UWCubeSat/coffee-can-radar/coffee-spring21/coffee-spring21.kicad_pcb

## KiCad design coffee-spring21/coffee-spring21.kicad_pcb (2021-04-18)

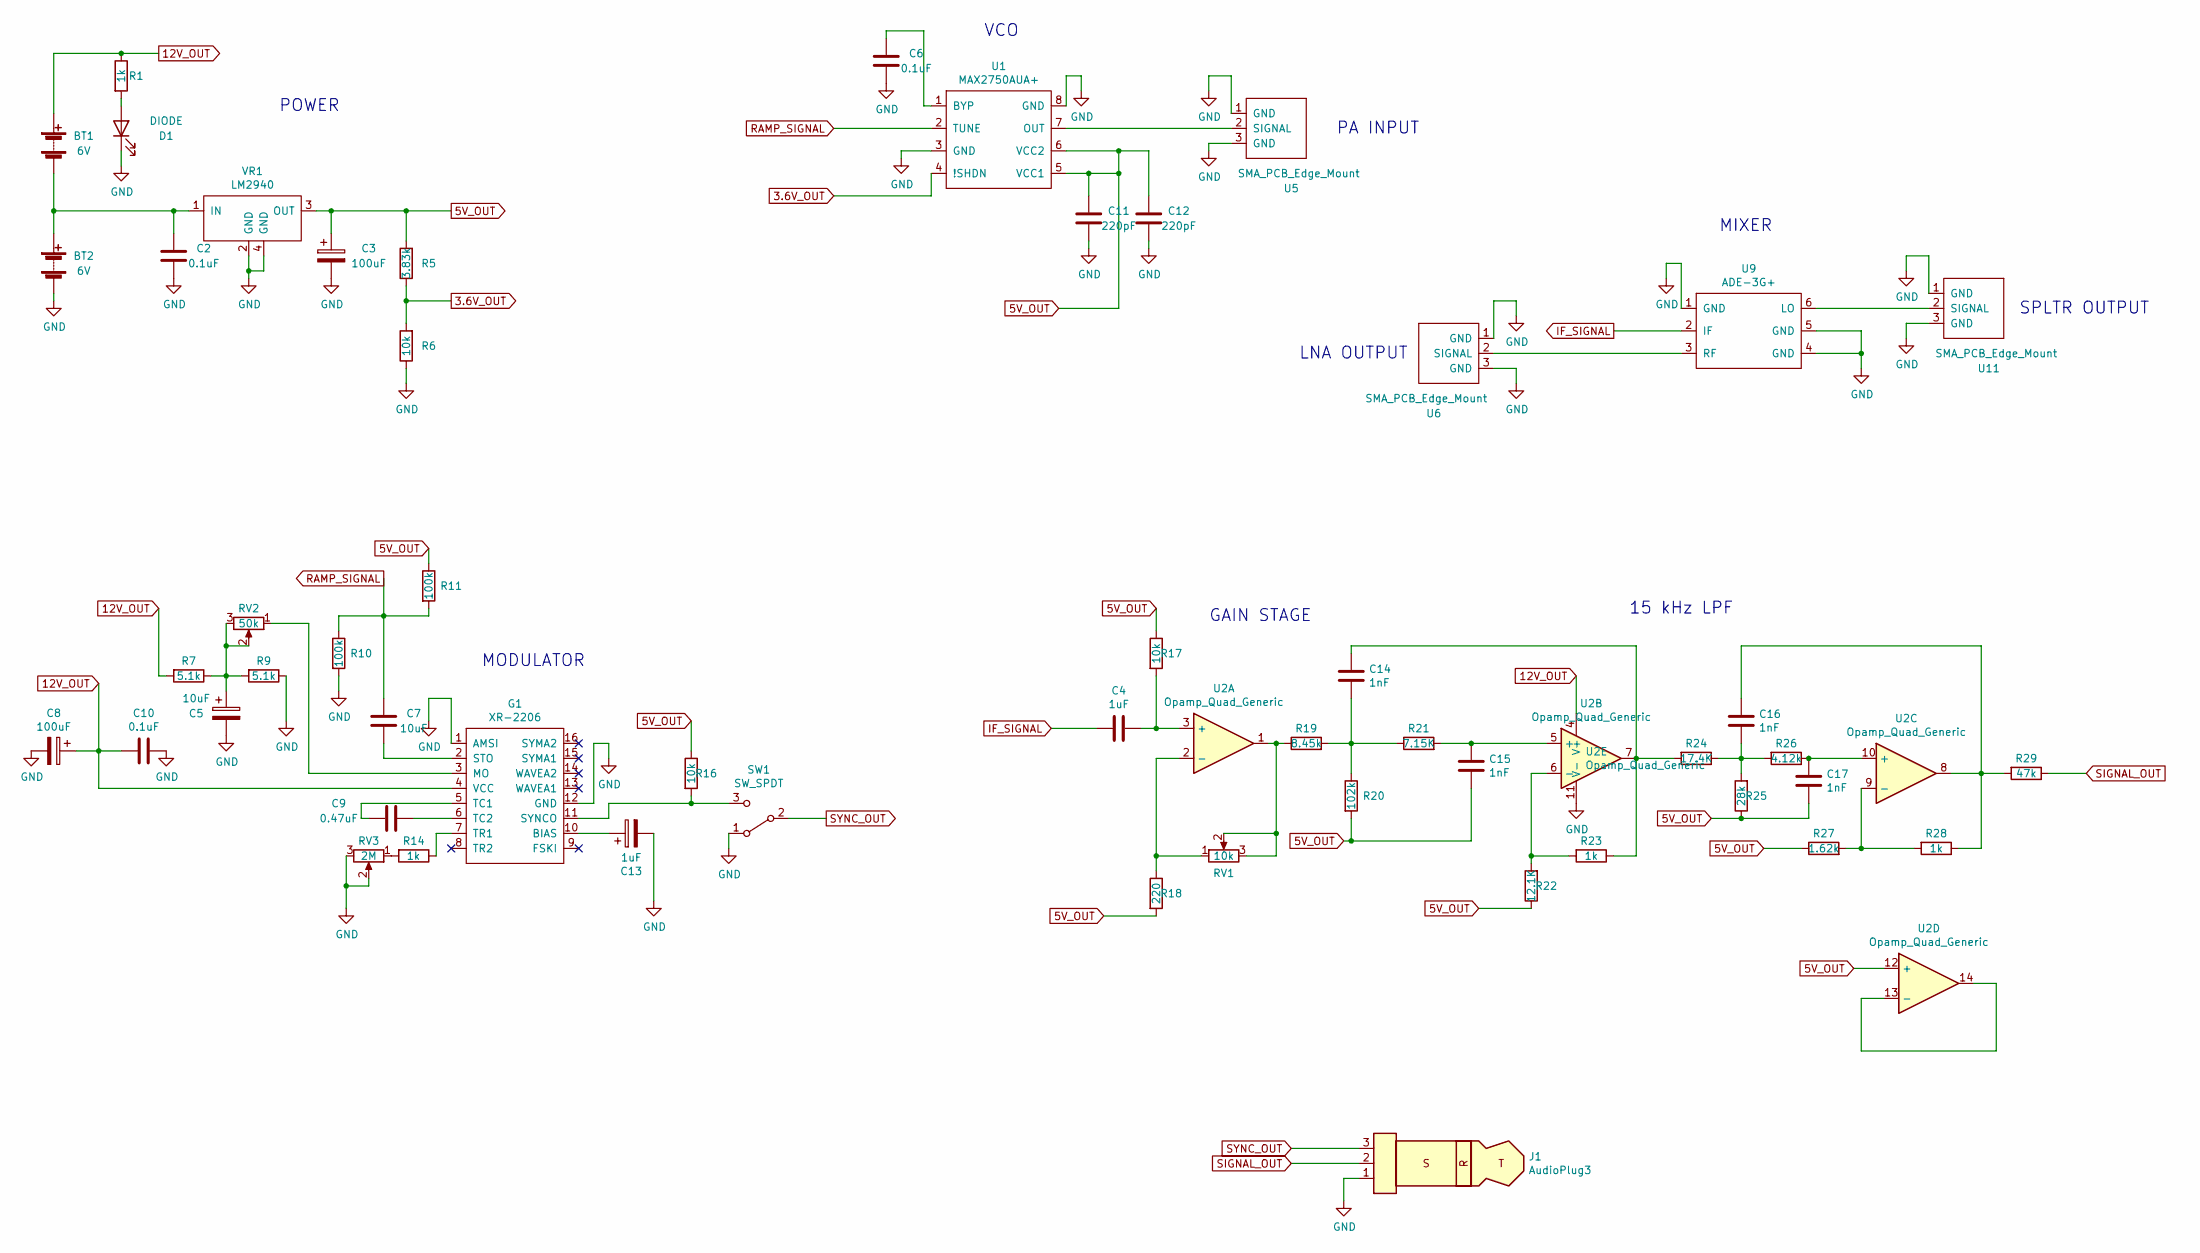
[picture p1: schematic coffee-spring21.sch, Coffee Can Radar]

Parts:
BT1, BT2: 6V; PinSocket_1x02_P2.54mm_Vertical
C2, C6, C10: 0.1uF; C_0805_2012Metric
C3, C8: 100uF; CP_Radial_D6.3mm_P2.50mm
C4: 1uF; C_0805_2012Metric
C5, C7: 10uF; CP_Radial_D5.0mm_P2.50mm
C9: 0.47uF; C_0805_2012Metric
C11, C12: 220pF; C_0805_2012Metric
C13: 1uF; CP_Radial_D4.0mm_P2.00mm
C14, C15, C16, C17: 1nF; C_0805_2012Metric
D1: DIODE; LED_D5.0mm
G1: XR-2206
J1: AudioPlug3; PinHeader_1x03_P2.54mm_Vertical
R1, R14, R23, R28: 1k; R_0805_2012Metric
R5: 3.83k; R_0805_2012Metric
R6, R16, R17: 10k; R_0805_2012Metric
R7, R9: 5.1k; R_Axial_DIN0204_L3.6mm_D1.6mm_P5.08mm_Horizontal
R10, R11: 100k; R_Axial_DIN0204_L3.6mm_D1.6mm_P5.08mm_Horizontal
R18: 220; R_Axial_DIN0207_L6.3mm_D2.5mm_P7.62mm_Horizontal
R19: 8.45k; R_0805_2012Metric
R20: 102k; R_0805_2012Metric
R21: 7.15K; R_0805_2012Metric
R22: 12.1K; R_0805_2012Metric
R24: 17.4K; R_0805_2012Metric
R25: 28k; R_0805_2012Metric
R26: 4.12k; R_0805_2012Metric
R27: 1.62k; R_0805_2012Metric
R29: 47k; R_Axial_DIN0207_L6.3mm_D2.5mm_P7.62mm_Horizontal
RV1: 10k; PV36W
RV2: 50k; PV36W
RV3: 2M; PV36W
SW1: SW_SPDT; PinHeader_1x03_P2.54mm_Vertical
U1: MAX2750AUA+
U2: Opamp_Quad_Generic; 21-0041B_14
U5, U6, U11: SMA_PCB_Edge_Mount; SMA_EDGE_MOUNT_132255
U9: ADE-3G+
VR1: LM2940

Connections:
3.6V_OUT: R5.1, R6.2, U1.4 (!SHDN)
5V_OUT: C3.1, C11.2, C12.2, C15.1, C17.1, R5.2, R11.1, R16.1, R17.1, R18.2, R20.2, R22.1, R25.1, R27.1, U1.5 (VCC1), U1.6 (VCC2), U2.12 (+), VR1.3 (OUT)
12V_OUT: BT1.1 (+), C8.1, C10.2, G1.4 (VCC), R1.1, R7.2, U2.4 (V+)
GND: BT2.2 (-), C2.2, C3.2, C5.2, C6.2, C8.2, C10.1, C11.1, C12.1, C13.2, D1.1 (K), G1.1 (AMSI), G1.12 (GND), J1.1, R6.1, R9.1, R10.2, RV3.2, RV3.3, SW1.1 (A), U1.3 (GND), U1.8 (GND), U2.11 (V-), U5.1 (GND), U5.3 (GND), U6.1 (GND), U6.3 (GND), U9.1 (GND), U9.4 (GND), U9.5 (GND), U11.1 (GND), U11.3 (GND), VR1.2 (GND), VR1.4 (GND)
IF_SIGNAL: C4.2, U9.2 (IF)
unnamed: BT1.2 (-), BT2.1 (+), C2.1, VR1.1 (IN)
unnamed: C4.1, R17.2, U2.3 (+)
unnamed: C5.1, R7.1, R9.2, RV2.2, RV2.3
unnamed: C6.1, U1.1 (BYP)
unnamed: C7.2, G1.2 (STO)
unnamed: C9.1, G1.6 (TC2)
unnamed: C9.2, G1.5 (TC1)
unnamed: C13.1, G1.10 (BIAS)
unnamed: C14.1, R19.2, R20.1, R21.1
unnamed: C14.2, R23.1, R24.2, U2.7
unnamed: C15.2, R21.2, U2.5 (+)
unnamed: C16.1, R24.1, R25.2, R26.2
unnamed: C16.2, R28.1, R29.2, U2.8
unnamed: C17.2, R26.1, U2.10 (+)
unnamed: D1.2 (A), R1.2
unnamed: G1.3 (MO), RV2.1
unnamed: G1.7 (TR1), R14.1
unnamed: G1.11 (SYNCO), R16.2, SW1.3 (C)
unnamed: R14.2, RV3.1
unnamed: R18.1, RV1.1, U2.2 (-)
unnamed: R19.1, RV1.2, RV1.3, U2.1
unnamed: R22.2, R23.2, U2.6 (-)
unnamed: R27.2, R28.2, U2.9 (-)
unnamed: U1.7 (OUT), U5.2 (SIGNAL)
unnamed: U2.13 (-), U2.14
unnamed: U6.2 (SIGNAL), U9.3 (RF)
unnamed: U9.6 (LO), U11.2 (SIGNAL)
RAMP_SIGNAL: C7.1, R10.1, R11.2, U1.2 (TUNE)
SIGNAL_OUT: J1.2, R29.1
SYNC_OUT: J1.3, SW1.2 (B)

Notes on the sheet:
VCO
MODULATOR
PA INPUT
15 kHz LPF
MIXER
GAIN STAGE
POWER
LNA OUTPUT
SPLTR OUTPUT

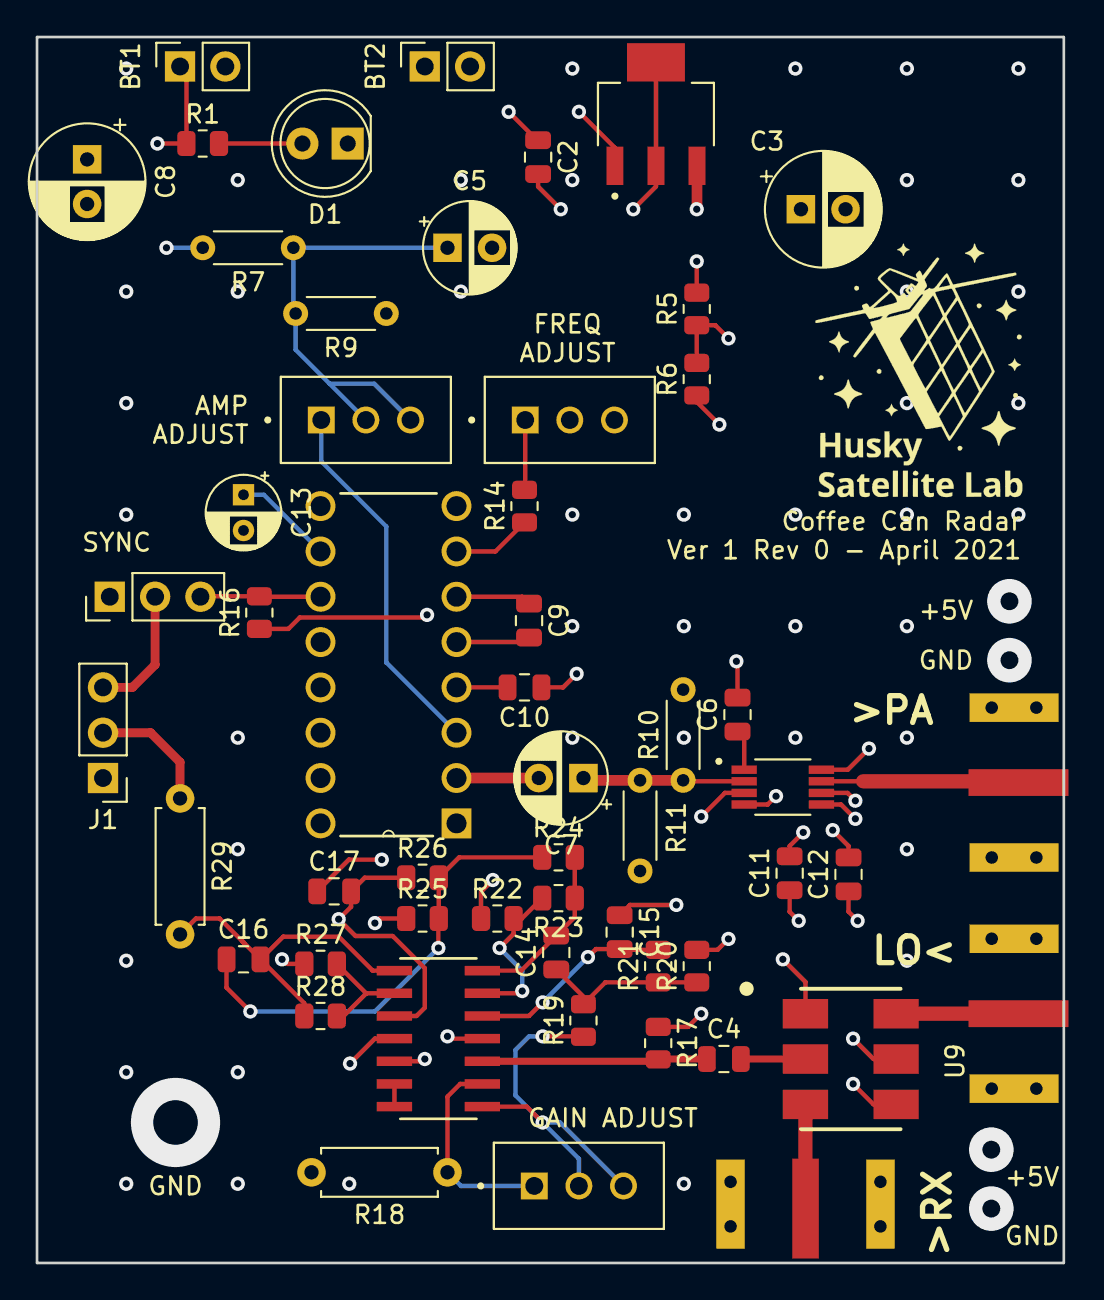
[picture p2: board coffee-spring21.kicad_pcb from above]

Board: 4 copper layers, 57.5 x 68.7 mm, 54 parts (0 on the bottom side), 35 nets.
