UWCubeSat/coffee-can-radar/(commit log)

2021-04-07 coffee can radar rev 1
    includes full board (tx and rx)
    [coffee-spring21.kicad_pcb, coffee-spring21.sch, coffee-vivaldi-tx.sch]
2021-04-12 Modified CCR layout
    Added through hold resistors, power and ground terminals for SMA PA and LNA.
    [coffee-spring21-B_Cu.gbr, coffee-spring21-B_Mask.gbr, coffee-spring21-B_Paste.gbr, coffee-spring21-B_SilkS.gbr, coffee-spring21-Edge_Cuts.gbr, coffee-spring21-F_Cu.gbr, coffee-spring21-F_Mask.gbr, coffee-spring21-F_Paste.gbr]
2021-04-18 Board edits before fabricating
    Via stitching, unused op-amp arrangement
    [coffee-spring21-B_Cu.gbr, coffee-spring21-B_Mask.gbr, coffee-spring21-B_Paste.gbr, coffee-spring21-B_SilkS.gbr, coffee-spring21-Edge_Cuts.gbr, coffee-spring21-F_Cu.gbr, coffee-spring21-F_Mask.gbr, coffee-spring21-F_Paste.gbr]
